ivanc25/S.C.A.L.E.-Smart_Coin_Allocation_Level_Evaluator/File_Mx_IDE/Core/Src/main.c

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
/* Includes ------------------------------------------------------------------*/
#include "main.h"

/* USER CODE BEGIN Includes */
#include "hx711.h"
#include <stdio.h>
#include <string.h>
#include "servo_tg9e.h"
#include "piggybank_app.h"
/* USER CODE END Includes */

/* USER CODE BEGIN PD */
#define HX711_TARE_SAMPLES          20U
#define HX711_AVERAGE_SAMPLES       5U
#define APP_STATUS_PERIOD_MS        500U
#define APP_BLE_NOTIFY_PERIOD_MS    500U
#define APP_UART_STATUS_ENABLE      1U
#define SERVO_OPEN_ANGLE            0U
#define SERVO_CLOSED_ANGLE          90U
/* USER CODE END PD */


PKA_HandleTypeDef hpka;

RNG_HandleTypeDef hrng;

TIM_HandleTypeDef htim17;

UART_HandleTypeDef huart1;

/* USER CODE BEGIN PV */
char messaggio_uart[180];
float pesi_reali[5] = {0.0f};
int monete_contate[5] = {0};

/* Peso nominale di una moneta per ogni canale fisico HX711.
   Ordine dei canali cablati: [0]=2€, [1]=50c, [2]=1€, [3]=20c, [4]=10c.
   I canali 50c e 1€ sono quindi mantenuti separati qui e riordinati solo
   nel pacchetto BLE, in modo da rispettare l'ordine mostrato nell'app. */
const float PESI_MONETE[5] = {8.50f, 7.80f, 7.50f, 5.74f, 4.10f};

/* Stato logico del servo: 0 = aperto, 1 = chiuso.
   La chiusura avviene esclusivamente quando il totale raggiunge il limite BLE. */
volatile uint8_t g_servo_closed_by_limit = 0U;
/* USER CODE END PV */

void SystemClock_Config(void);
void PeriphCommonClock_Config(void);
static void MX_GPIO_Init(void);
void MX_USART1_UART_Init(void);
static void MX_TIM17_Init(void);
static void MX_RNG_Init(void);
static void MX_RADIO_Init(void);
static void MX_RADIO_TIMER_Init(void);
static void MX_PKA_Init(void);
/* USER CODE BEGIN PFP */
static void App_UpdateCoinCounts(void);
static uint32_t App_GetTotalCents(void);
static void App_SendBleCoins(void);
static void App_HandleUartDebug(void);
static void App_UpdateServoFromLimit(void);
static void App_PrintStatusUart(void);
static void App_PrintHelp(void);
/* USER CODE END PFP */

/* USER CODE BEGIN 0 */
/* Converte i pesi misurati in numero di monete.
   La piccola banda morta attorno allo zero riduce oscillazioni dovute al rumore. */
static void App_UpdateCoinCounts(void)
{
  for (uint8_t i = 0U; i < 5U; i++)
  {
    if ((pesi_reali[i] > -2.0f) && (pesi_reali[i] < 2.0f))
    {
      pesi_reali[i] = 0.0f;
    }

    if (pesi_reali[i] <= 0.0f)
    {
      monete_contate[i] = 0;
    }
    else
    {
      monete_contate[i] = (int)((pesi_reali[i] / PESI_MONETE[i]) + 0.5f);
    }
  }
}

/* Calcola il valore totale usando l'ordine fisico dei cinque canali HX711. */
static uint32_t App_GetTotalCents(void)
{
  uint32_t total = 0U;

  if (monete_contate[0] > 0) { total += (uint32_t)monete_contate[0] * 200U; } /* channel 0 = 2€ */
  if (monete_contate[1] > 0) { total += (uint32_t)monete_contate[1] *  50U; } /* channel 1 = 50c */
  if (monete_contate[2] > 0) { total += (uint32_t)monete_contate[2] * 100U; } /* channel 2 = 1€ */
  if (monete_contate[3] > 0) { total += (uint32_t)monete_contate[3] *  20U; } /* channel 3 = 20c */
  if (monete_contate[4] > 0) { total += (uint32_t)monete_contate[4] *  10U; } /* channel 4 = 10c */

  return total;
}

/* Le notifiche BLE inviano un byte per moneta: il conteggio viene saturato a 8 bit. */
static uint8_t App_ClampCoinCountToU8(int count)
{
  if (count < 0)
  {
    return 0U;
  }
  if (count > 255)
  {
    return 255U;
  }
  return (uint8_t)count;
}

static void App_SendBleCoins(void)
{
  /* Formato del pacchetto BLE COINS inviato all'app:
     byte 0 = 2€, byte 1 = 1€, byte 2 = 50c, byte 3 = 20c, byte 4 = 10c.
     Il riordino tra canale fisico e visualizzazione avviene solo in questo punto. */
  uint8_t coin_payload[5];

  coin_payload[0] = App_ClampCoinCountToU8(monete_contate[0]); /* 2€  */
  coin_payload[1] = App_ClampCoinCountToU8(monete_contate[2]); /* 1€  */
  coin_payload[2] = App_ClampCoinCountToU8(monete_contate[1]); /* 50c */
  coin_payload[3] = App_ClampCoinCountToU8(monete_contate[3]); /* 20c */
  coin_payload[4] = App_ClampCoinCountToU8(monete_contate[4]); /* 10c */

  PIGGYBANK_APP_SendCoins(coin_payload);
}

static void App_HandleUartDebug(void)
{
  uint8_t dato_ricevuto = 0U;

  /* Lettura UART non bloccante: la seriale è usata solo per richiesta di help/stato. */
  if (HAL_UART_Receive(&huart1, &dato_ricevuto, 1U, 0U) == HAL_OK)
  {
    if ((dato_ricevuto == '?') || (dato_ricevuto == 'h') || (dato_ricevuto == 'H'))
    {
      App_PrintHelp();
    }
  }
}

/* Aggiorna il servo solo quando cambia la condizione di soglia.
   Questo evita di riscrivere continuamente il PWM a ogni ciclo del main loop. */
static void App_UpdateServoFromLimit(void)
{
  static uint8_t last_closed_state = 0xFFU;
  uint32_t limit_cents = PIGGYBANK_APP_GetLimitValue();
  uint32_t total_cents = App_GetTotalCents();
  uint8_t should_close = ((limit_cents > 0U) && (total_cents >= limit_cents)) ? 1U : 0U;

  if (should_close != last_closed_state)
  {
    if (should_close != 0U)
    {
      ServoTG9e_SetAngle(SERVO_CLOSED_ANGLE);
      APP_DBG_MSG("Servo CLOSED: total=%lu cents limit=%lu cents\r\n", total_cents, limit_cents);
    }
    else
    {
      ServoTG9e_SetAngle(SERVO_OPEN_ANGLE);
      APP_DBG_MSG("Servo OPEN: total=%lu cents limit=%lu cents\r\n", total_cents, limit_cents);
    }

    g_servo_closed_by_limit = should_close;
    last_closed_state = should_close;
  }
}

static void App_PrintStatusUart(void)
{
#if (APP_UART_STATUS_ENABLE != 0U)
  uint32_t total_cents = App_GetTotalCents();
  uint32_t limit_cents = PIGGYBANK_APP_GetLimitValue();

  snprintf(messaggio_uart, sizeof(messaggio_uart),
           "2E:%d (%.1fg) | 50c:%d (%.1fg) | 1E:%d (%.1fg) | 20c:%d (%.1fg) | 10c:%d (%.1fg) | total:%lu.%02lu EUR | limit:%lu.%02lu EUR | servo:%s\r\n",
           monete_contate[0], pesi_reali[0],
           monete_contate[1], pesi_reali[1],
           monete_contate[2], pesi_reali[2],
           monete_contate[3], pesi_reali[3],
           monete_contate[4], pesi_reali[4],
           total_cents / 100U, total_cents % 100U,
           limit_cents / 100U, limit_cents % 100U,
           (g_servo_closed_by_limit != 0U) ? "CLOSED" : "OPEN");

  HAL_UART_Transmit(&huart1, (uint8_t*)messaggio_uart, strlen(messaggio_uart), 10U);
#endif
}

static void App_PrintHelp(void)
{
  const char help[] =
      "\r\nPiggyBank no-motor firmware\r\n"
      "  BLE COINS : notify 5 coin-count bytes\r\n"
      "  BLE LIMIT : write uint32 little-endian cents\r\n"
      "  Servo     : OPEN until total >= LIMIT, then CLOSED\r\n"
      "  Motor/MOSFET and UART servo control are disabled.\r\n";
  HAL_UART_Transmit(&huart1, (uint8_t*)help, strlen(help), 100U);
}

int __io_putchar(int ch)
{
  uint8_t c = (uint8_t)ch;
  HAL_UART_Transmit(&huart1, &c, 1U, HAL_MAX_DELAY);
  return ch;
}
/* USER CODE END 0 */

/**
  * @brief  The application entry point.
  * @retval int
  */
int main(void)
{

  /* MCU Configuration--------------------------------------------------------*/

  /* Reset of all peripherals, Initializes the Flash interface and the Systick. */
  HAL_Init();

  /* Configure the system clock */
  SystemClock_Config();

  /* Configure the peripherals common clocks */
  PeriphCommonClock_Config();

  /* Initialize all configured peripherals */
  MX_GPIO_Init();
  MX_USART1_UART_Init();
  MX_TIM17_Init();
  MX_RNG_Init();
  MX_RADIO_Init();
  MX_RADIO_TIMER_Init();
  MX_PKA_Init();
  /* USER CODE BEGIN 2 */
  char test[] = "\r\n--- PIGGYBANK START: BLE + HX711 + SERVO LIMIT CONTROL ---\r\n";
  HAL_UART_Transmit(&huart1, (uint8_t*)test, strlen(test), 50U);

  /* Fattori di calibrazione dei cinque canali HX711, ottenuti con pesi noti. */
  HX711_SetScales(1050.0f, 1044.5f, 1007.0f, 1073.9f, 1017.39f);
  HX711_TareAllBegin();

  /* Servo collegato a TIM17 CH1 / PA9.
     All'avvio resta aperto; la chiusura dipende soltanto dalla soglia BLE LIMIT. */
  ServoTG9e_Init(&htim17, TIM_CHANNEL_1);
  ServoTG9e_SetAngle(SERVO_OPEN_ANGLE);
  g_servo_closed_by_limit = 0U;

  App_PrintHelp();

  char menu[] = "BLE name: PiggyBank. Use the web app/nRF Connect, not the normal phone Bluetooth menu.\r\n";
  HAL_UART_Transmit(&huart1, (uint8_t*)menu, strlen(menu), 50U);

  char ble_init_msg[] = "Starting BLE stack...\r\n";
  HAL_UART_Transmit(&huart1, (uint8_t*)ble_init_msg, strlen(ble_init_msg), 50U);

  /* USER CODE END 2 */

  /* Init code for STM32_BLE */
  MX_APPE_Init(NULL);

  /* USER CODE BEGIN BLE_Init_Done */
  char ble_done_msg[] = "BLE init finished. Scan for BLE device: PiggyBank\r\n";
  HAL_UART_Transmit(&huart1, (uint8_t*)ble_done_msg, strlen(ble_done_msg), 50U);
  /* USER CODE END BLE_Init_Done */

  /* Infinite loop */
  /* USER CODE BEGIN WHILE */

  uint8_t hx711_tare_done = 0U;
  uint32_t last_status_tick = 0U;
  uint32_t last_ble_notify_tick = 0U;

  while (1)
  {
    uint32_t now = HAL_GetTick();

    App_HandleUartDebug();

    /* La tara viene eseguita in modo cooperativo: il BLE continua a essere processato. */
    if (hx711_tare_done == 0U)
    {
      if (HX711_TareAllTask(HX711_TARE_SAMPLES) != 0U)
      {
        hx711_tare_done = 1U;
        char tare_msg[] = "HX711 tare completed\r\n";
        HAL_UART_Transmit(&huart1, (uint8_t*)tare_msg, strlen(tare_msg), 50U);
      }
    }
    else
    {
      /* Ogni nuova media valida aggiorna conteggio monete, servo e notifica BLE. */
      if (HX711_GetWeightsAveragedTask(pesi_reali, HX711_AVERAGE_SAMPLES) != 0U)
      {
        App_UpdateCoinCounts();
        App_UpdateServoFromLimit();

        if ((now - last_ble_notify_tick) >= APP_BLE_NOTIFY_PERIOD_MS)
        {
          last_ble_notify_tick = now;
          App_SendBleCoins();
        }
      }

      /* Stampa periodica su UART utile durante collaudo e calibrazione. */
      if ((now - last_status_tick) >= APP_STATUS_PERIOD_MS)
      {
        last_status_tick = now;
        App_PrintStatusUart();
      }
    }
    /* USER CODE END WHILE */
    MX_APPE_Process();
    App_UpdateServoFromLimit();

    /* USER CODE BEGIN 3 */
  }
  /* USER CODE END 3 */
}

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
/* USER CODE BEGIN 4 */
/* No motor/PWM callbacks in this version. */
/* USER CODE END 4 */
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
