ivanc25/S.C.A.L.E.-Smart_Coin_Allocation_Level_Evaluator/File_Mx_IDE/Core/Inc/main.h

#define HX711_DATA2_Pin GPIO_PIN_3
#define HX711_DATA2_GPIO_Port GPIOB
#define HX711_DATA3_Pin GPIO_PIN_8
#define HX711_DATA3_GPIO_Port GPIOA
#define HX711_DATA4_Pin GPIO_PIN_11
#define HX711_DATA4_GPIO_Port GPIOA
#define HX711_DATA5_Pin GPIO_PIN_15
#define HX711_DATA5_GPIO_Port GPIOB
#define HX711_SCK_Pin GPIO_PIN_7
#define HX711_SCK_GPIO_Port GPIOB
#define HX711_DATA1_Pin GPIO_PIN_6
#define HX711_DATA1_GPIO_Port GPIOB
