ivanc25/S.C.A.L.E.-Smart_Coin_Allocation_Level_Evaluator/(notices)

Notices in the files:
File_Mx_IDE/Core/Inc/main.h:
Copyright (c) 2026 STMicroelectronics.
All rights reserved.
This software is licensed under terms that can be found in the LICENSE file
File_Mx_IDE/Projects/Common/BLE/Modules/asm.h:
Copyright (c) 2024 STMicroelectronics.
